alexmanuel27/PlanktoScope/Code/samples/photo_1764875718.jpg

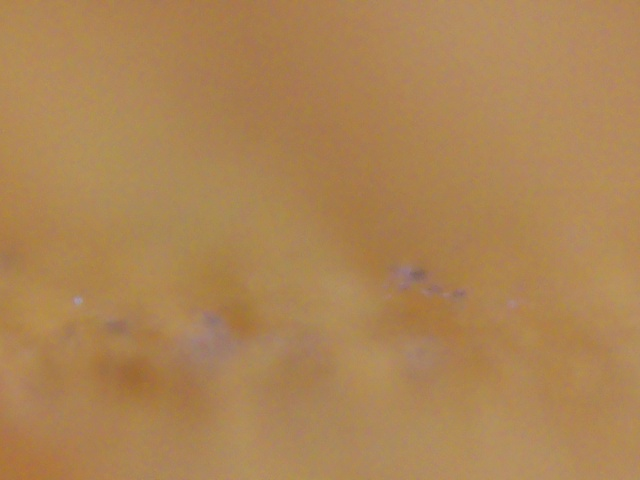
Code/samples/photo_1764875718.jpg
