alexmanuel27/PlanktoScope/Code/samples/photo_1764862161.jpg

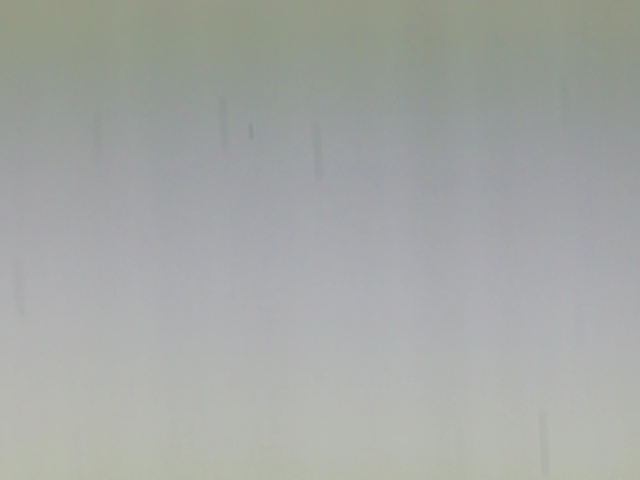
Code/samples/photo_1764862161.jpg
