alexmanuel27/PlanktoScope/Code/samples/photo_1764635275.jpg

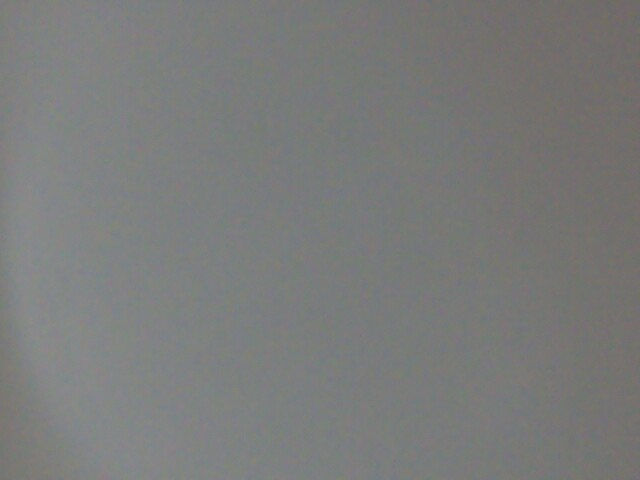
Code/samples/photo_1764635275.jpg
