alexmanuel27/PlanktoScope/datos/dataset_pm_mezcla_de_fuentes.jpg

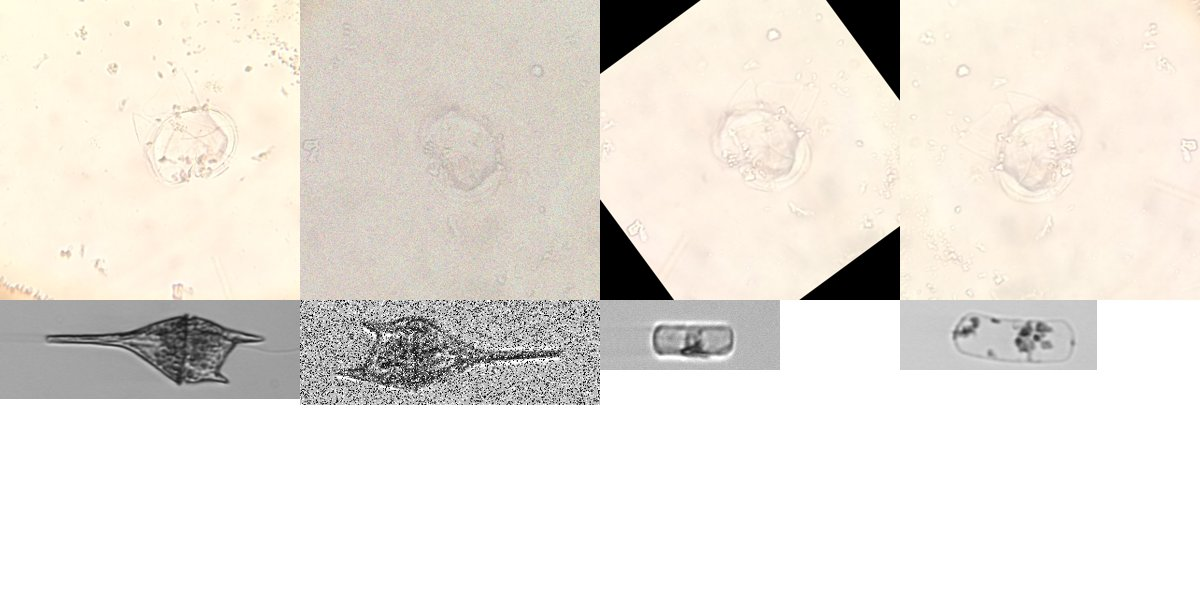
datos/dataset_pm_mezcla_de_fuentes.jpg
