alexmanuel27/PlanktoScope/modelos/plankton_mobilenet_v1/evaluacion_2026-09-27/confusion_limpio.png

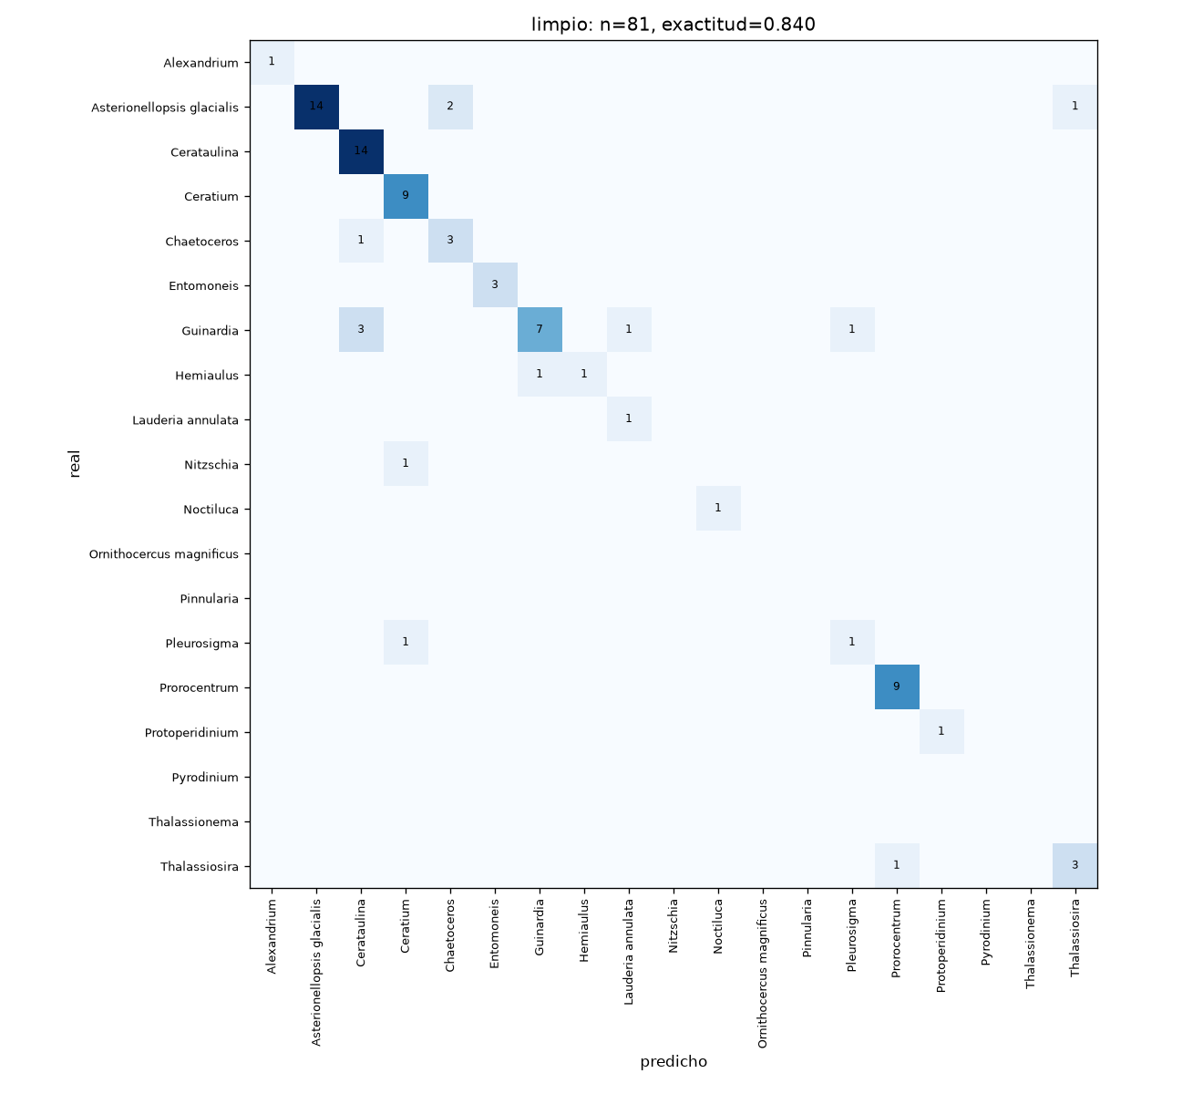
modelos/plankton_mobilenet_v1/evaluacion_2026-09-27/confusion_limpio.png
