alexmanuel27/PlanktoScope/(list of files, cad)

Other CAD files:
hardware/v2.1/case/PlanktoScope-Case (2)/0e850c2d-e7ce-4351-bac2-d7c185d7e647.f3d
hardware/v2.1/case/PlanktoScope-Case (2)/17e05918-feff-47e6-b392-b7af91a85d3e.f3d
hardware/v2.1/case/PlanktoScope-Case (2)/1a4a2817-b5f8-420c-9792-b29e91e8dcca.f3d
hardware/v2.1/case/PlanktoScope-Case (2)/1b2bbe5d-ce81-4713-bd27-330c6014a240.f3d
hardware/v2.1/case/PlanktoScope-Case (2)/1d477337-65d0-4aad-b7a3-bad6856ccf32.zip.f3d
hardware/v2.1/case/PlanktoScope-Case (2)/229278cc-a63a-4d60-ae79-3476006706c1.f3d
hardware/v2.1/case/PlanktoScope-Case (2)/39c13b6d-fd2f-492e-8767-e4eedb401456.f3d
hardware/v2.1/case/PlanktoScope-Case (2)/461afe21-81f9-453a-bc91-5f27020606c2.f3d
hardware/v2.1/case/PlanktoScope-Case (2)/48ae51cf-e409-4220-95ad-252bbba6209d.f3d
hardware/v2.1/case/PlanktoScope-Case (2)/49be9cc5-48d0-4a67-ab84-523c2f441036.f3d
hardware/v2.1/case/PlanktoScope-Case (2)/4abdbfde-54a1-46a7-9963-f6d3188fe159.f3d
hardware/v2.1/case/PlanktoScope-Case (2)/4e31985a-809a-47d1-84f4-eedf3f08d84d.f3d
hardware/v2.1/case/PlanktoScope-Case (2)/56b91e30-9c9f-4622-ba18-10aca97f1285.f3d
hardware/v2.1/case/PlanktoScope-Case (2)/5f8b7102-ca93-4f7e-ae2b-db1e94d02069.f3d
hardware/v2.1/case/PlanktoScope-Case (2)/6f789a65-b11d-4e2b-93b2-fccd86011b95.f3d
hardware/v2.1/case/PlanktoScope-Case (2)/71fed6c2-d2d2-4d90-9942-e3761ebb623a.f3d
hardware/v2.1/case/PlanktoScope-Case (2)/72acd83e-c714-40fa-b40f-245e58b6bd44.zip.f3d
hardware/v2.1/case/PlanktoScope-Case (2)/894af5d2-3cf9-48ae-962d-a460dfa0871c.f3d
hardware/v2.1/case/PlanktoScope-Case (2)/89d0933f-1a56-4870-be95-093551b69134.f3d
hardware/v2.1/case/PlanktoScope-Case (2)/a99cfc2e-9a65-4d40-9298-27492d5f2bd9.f3d
hardware/v2.1/case/PlanktoScope-Case (2)/b6c1d7c7-71d5-4f8c-a852-1080e0dc13f3.f3d
hardware/v2.1/case/PlanktoScope-Case (2)/b751b17d-3eb0-41a0-9004-12ad02d45ce2.f3d
hardware/v2.1/case/PlanktoScope-Case (2)/be1215d4-c3ec-41a3-ab22-ad0e6fc781e9.f3d
hardware/v2.1/case/PlanktoScope-Case (2)/ccd2134e-c44e-4f11-bd71-6ef3f181163e.f3d
hardware/v2.1/case/PlanktoScope-Case (2)/dddd11c0-e493-488c-b1b6-4b4cd47b6b13.f3d
hardware/v2.1/case/PlanktoScope-Case (2)/df5fb8b6-cb67-4064-a8af-0fe8c923339c.f3d
hardware/v2.1/case/PlanktoScope-Case (2)/fcee8e9f-2545-4671-880a-8952077a5481.f3d
hardware/v2.1/case/PlanktoScope-Case/0e850c2d-e7ce-4351-bac2-d7c185d7e647.f3d
hardware/v2.1/case/PlanktoScope-Case/17e05918-feff-47e6-b392-b7af91a85d3e.f3d
hardware/v2.1/case/PlanktoScope-Case/1a4a2817-b5f8-420c-9792-b29e91e8dcca.f3d
hardware/v2.1/case/PlanktoScope-Case/1b2bbe5d-ce81-4713-bd27-330c6014a240.f3d
hardware/v2.1/case/PlanktoScope-Case/1d477337-65d0-4aad-b7a3-bad6856ccf32.zip.f3d
hardware/v2.1/case/PlanktoScope-Case/229278cc-a63a-4d60-ae79-3476006706c1.f3d
hardware/v2.1/case/PlanktoScope-Case/39c13b6d-fd2f-492e-8767-e4eedb401456.f3d
hardware/v2.1/case/PlanktoScope-Case/461afe21-81f9-453a-bc91-5f27020606c2.f3d
hardware/v2.1/case/PlanktoScope-Case/48ae51cf-e409-4220-95ad-252bbba6209d.f3d
hardware/v2.1/case/PlanktoScope-Case/49be9cc5-48d0-4a67-ab84-523c2f441036.f3d
hardware/v2.1/case/PlanktoScope-Case/4abdbfde-54a1-46a7-9963-f6d3188fe159.f3d
hardware/v2.1/case/PlanktoScope-Case/4e31985a-809a-47d1-84f4-eedf3f08d84d.f3d
hardware/v2.1/case/PlanktoScope-Case/56b91e30-9c9f-4622-ba18-10aca97f1285.f3d
hardware/v2.1/case/PlanktoScope-Case/5f8b7102-ca93-4f7e-ae2b-db1e94d02069.f3d
hardware/v2.1/case/PlanktoScope-Case/6f789a65-b11d-4e2b-93b2-fccd86011b95.f3d
hardware/v2.1/case/PlanktoScope-Case/71fed6c2-d2d2-4d90-9942-e3761ebb623a.f3d
hardware/v2.1/case/PlanktoScope-Case/72acd83e-c714-40fa-b40f-245e58b6bd44.zip.f3d
hardware/v2.1/case/PlanktoScope-Case/894af5d2-3cf9-48ae-962d-a460dfa0871c.f3d
hardware/v2.1/case/PlanktoScope-Case/89d0933f-1a56-4870-be95-093551b69134.f3d
hardware/v2.1/case/PlanktoScope-Case/a99cfc2e-9a65-4d40-9298-27492d5f2bd9.f3d
hardware/v2.1/case/PlanktoScope-Case/b6c1d7c7-71d5-4f8c-a852-1080e0dc13f3.f3d
hardware/v2.1/case/PlanktoScope-Case/b751b17d-3eb0-41a0-9004-12ad02d45ce2.f3d
hardware/v2.1/case/PlanktoScope-Case/be1215d4-c3ec-41a3-ab22-ad0e6fc781e9.f3d
hardware/v2.1/case/PlanktoScope-Case/ccd2134e-c44e-4f11-bd71-6ef3f181163e.f3d
hardware/v2.1/case/PlanktoScope-Case/dddd11c0-e493-488c-b1b6-4b4cd47b6b13.f3d
hardware/v2.1/case/PlanktoScope-Case/df5fb8b6-cb67-4064-a8af-0fe8c923339c.f3d
hardware/v2.1/case/PlanktoScope-Case/fcee8e9f-2545-4671-880a-8952077a5481.f3d
