alexmanuel27/PlanktoScope/modelos/plankton_mobilenet_v1/evaluacion_2026-09-27/predicciones_test_original.csv

imagen | real | predicho | confianza
test/Alexandrium/1_0.png | Alexandrium | Alexandrium | 1.0000
test/Alexandrium/1_1.png | Alexandrium | Alexandrium | 0.9995
test/Asterionellopsis glacialis/2_0.png | Asterionellopsis glacialis | Asterionellopsis glacialis | 0.9997
test/Asterionellopsis glacialis/2_1.png | Asterionellopsis glacialis | Asterionellopsis glacialis | 0.9999
test/Asterionellopsis glacialis/2_10.png | Asterionellopsis glacialis | Asterionellopsis glacialis | 0.9999
test/Asterionellopsis glacialis/2_11.png | Asterionellopsis glacialis | Asterionellopsis glacialis | 1.0000
test/Asterionellopsis glacialis/2_12.png | Asterionellopsis glacialis | Asterionellopsis glacialis | 0.9999
test/Asterionellopsis glacialis/2_13.png | Asterionellopsis glacialis | Asterionellopsis glacialis | 0.9981
test/Asterionellopsis glacialis/2_14.png | Asterionellopsis glacialis | Asterionellopsis glacialis | 1.0000
test/Asterionellopsis glacialis/2_15.png | Asterionellopsis glacialis | Asterionellopsis glacialis | 0.9953
test/Asterionellopsis glacialis/2_16.png | Asterionellopsis glacialis | Asterionellopsis glacialis | 0.9999
test/Asterionellopsis glacialis/2_17.png | Asterionellopsis glacialis | Asterionellopsis glacialis | 0.9981
test/Asterionellopsis glacialis/2_18.png | Asterionellopsis glacialis | Asterionellopsis glacialis | 0.9999
test/Asterionellopsis glacialis/2_2.png | Asterionellopsis glacialis | Asterionellopsis glacialis | 0.9973
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
test/Thalassiosira/19_3.png | Thalassiosira | Thalassiosira | 0.9998
test/Thalassiosira/19_4.png | Thalassiosira | Thalassiosira | 0.9982
test/Thalassiosira/19_5.png | Thalassiosira | Thalassiosira | 0.9999
test/Thalassiosira/19_6.png | Thalassiosira | Thalassiosira | 1.0000
