alexmanuel27/PlanktoScope/hardware/v2.5/hat/salida.pdf

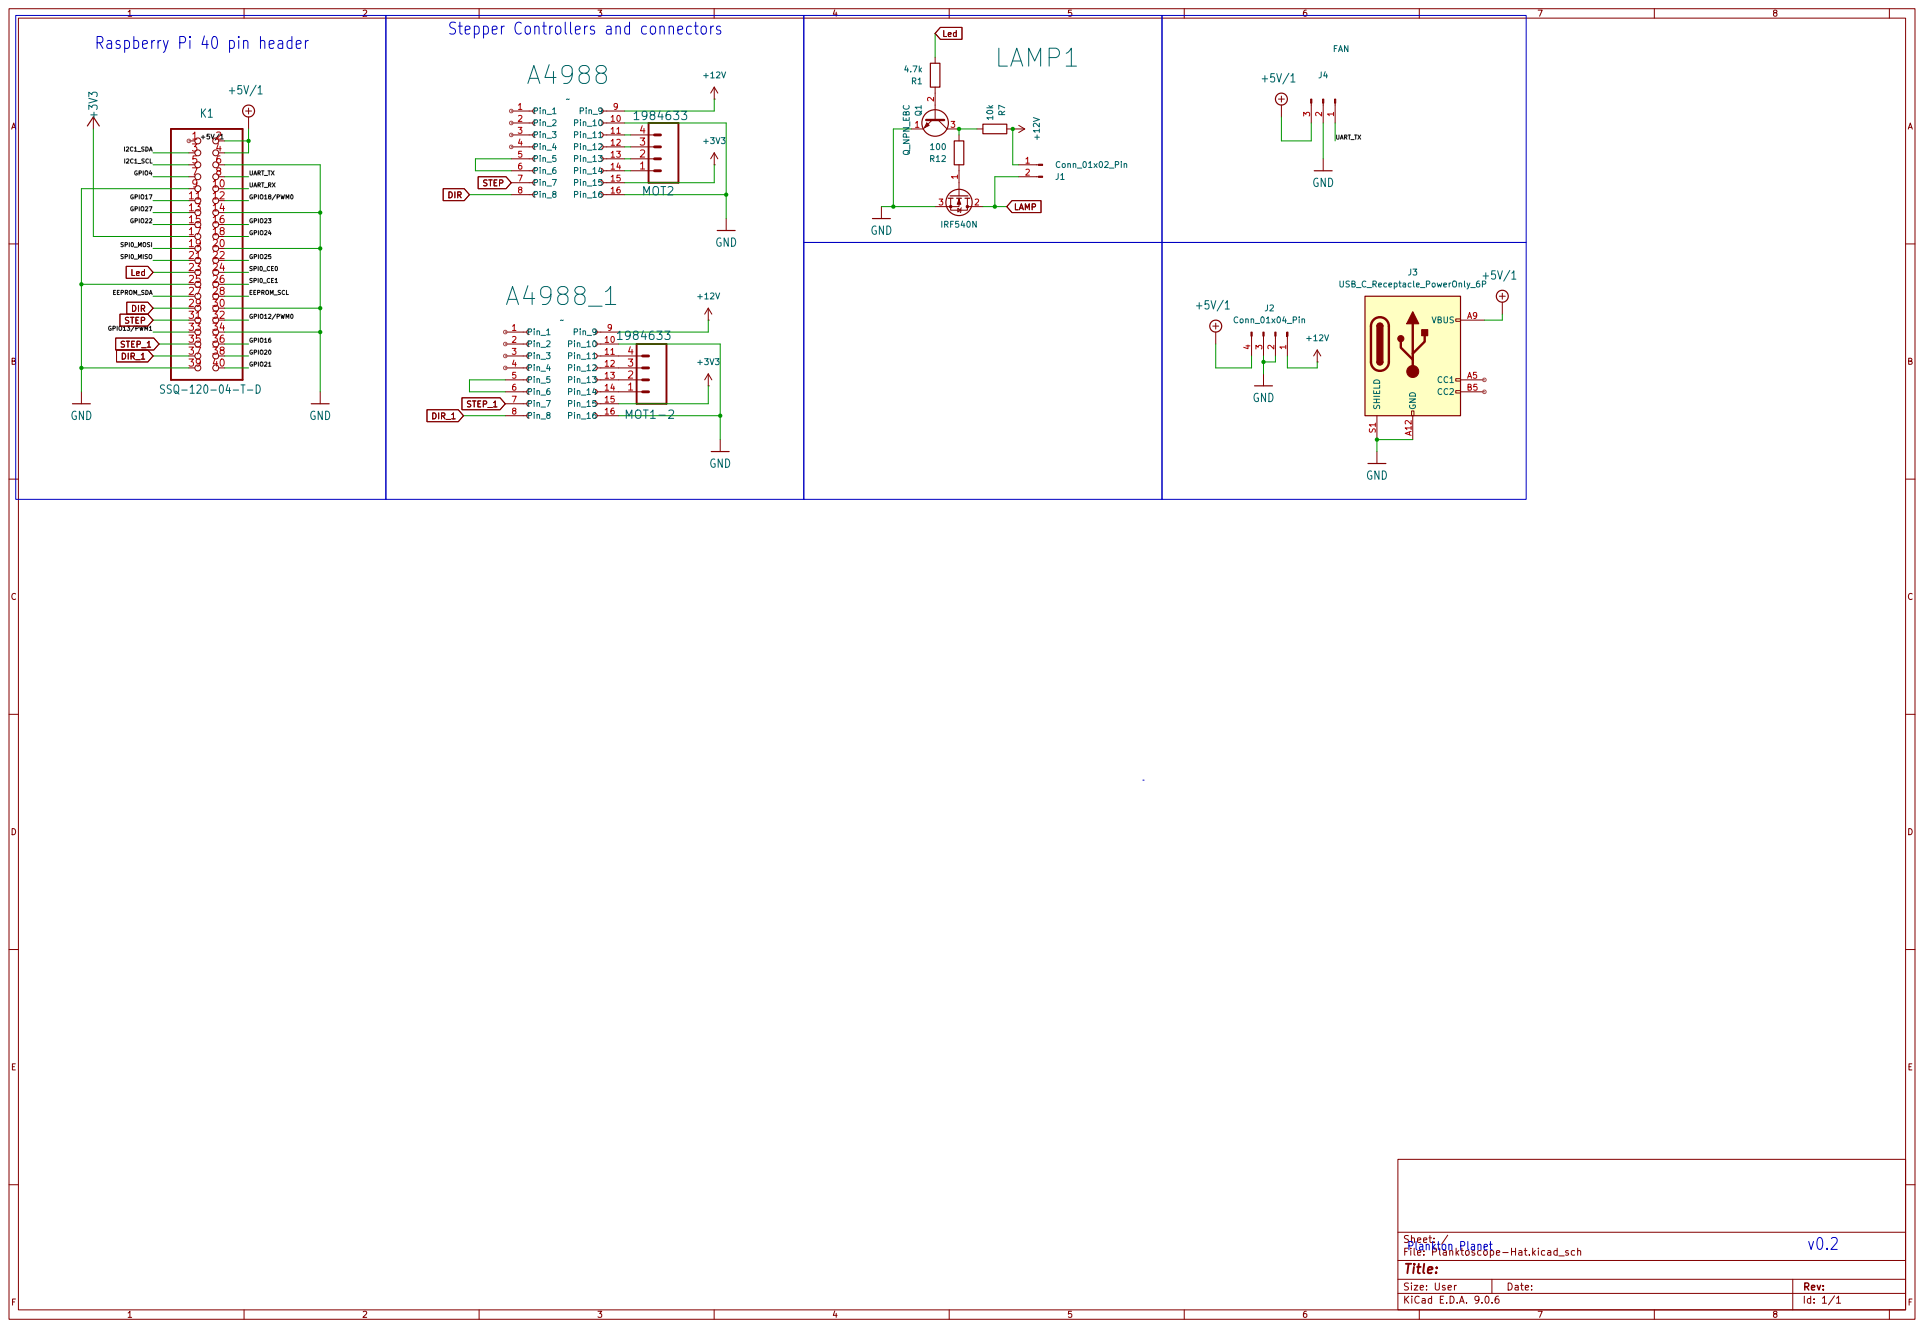
[picture p6: page 1]
