alexmanuel27/PlanktoScope/hardware/v2.5/hat/Planktoscope-Hat.kicad_pcb

## KiCad design hardware/v2.5/hat/Planktoscope-Hat.kicad_pcb (2025-12-02)

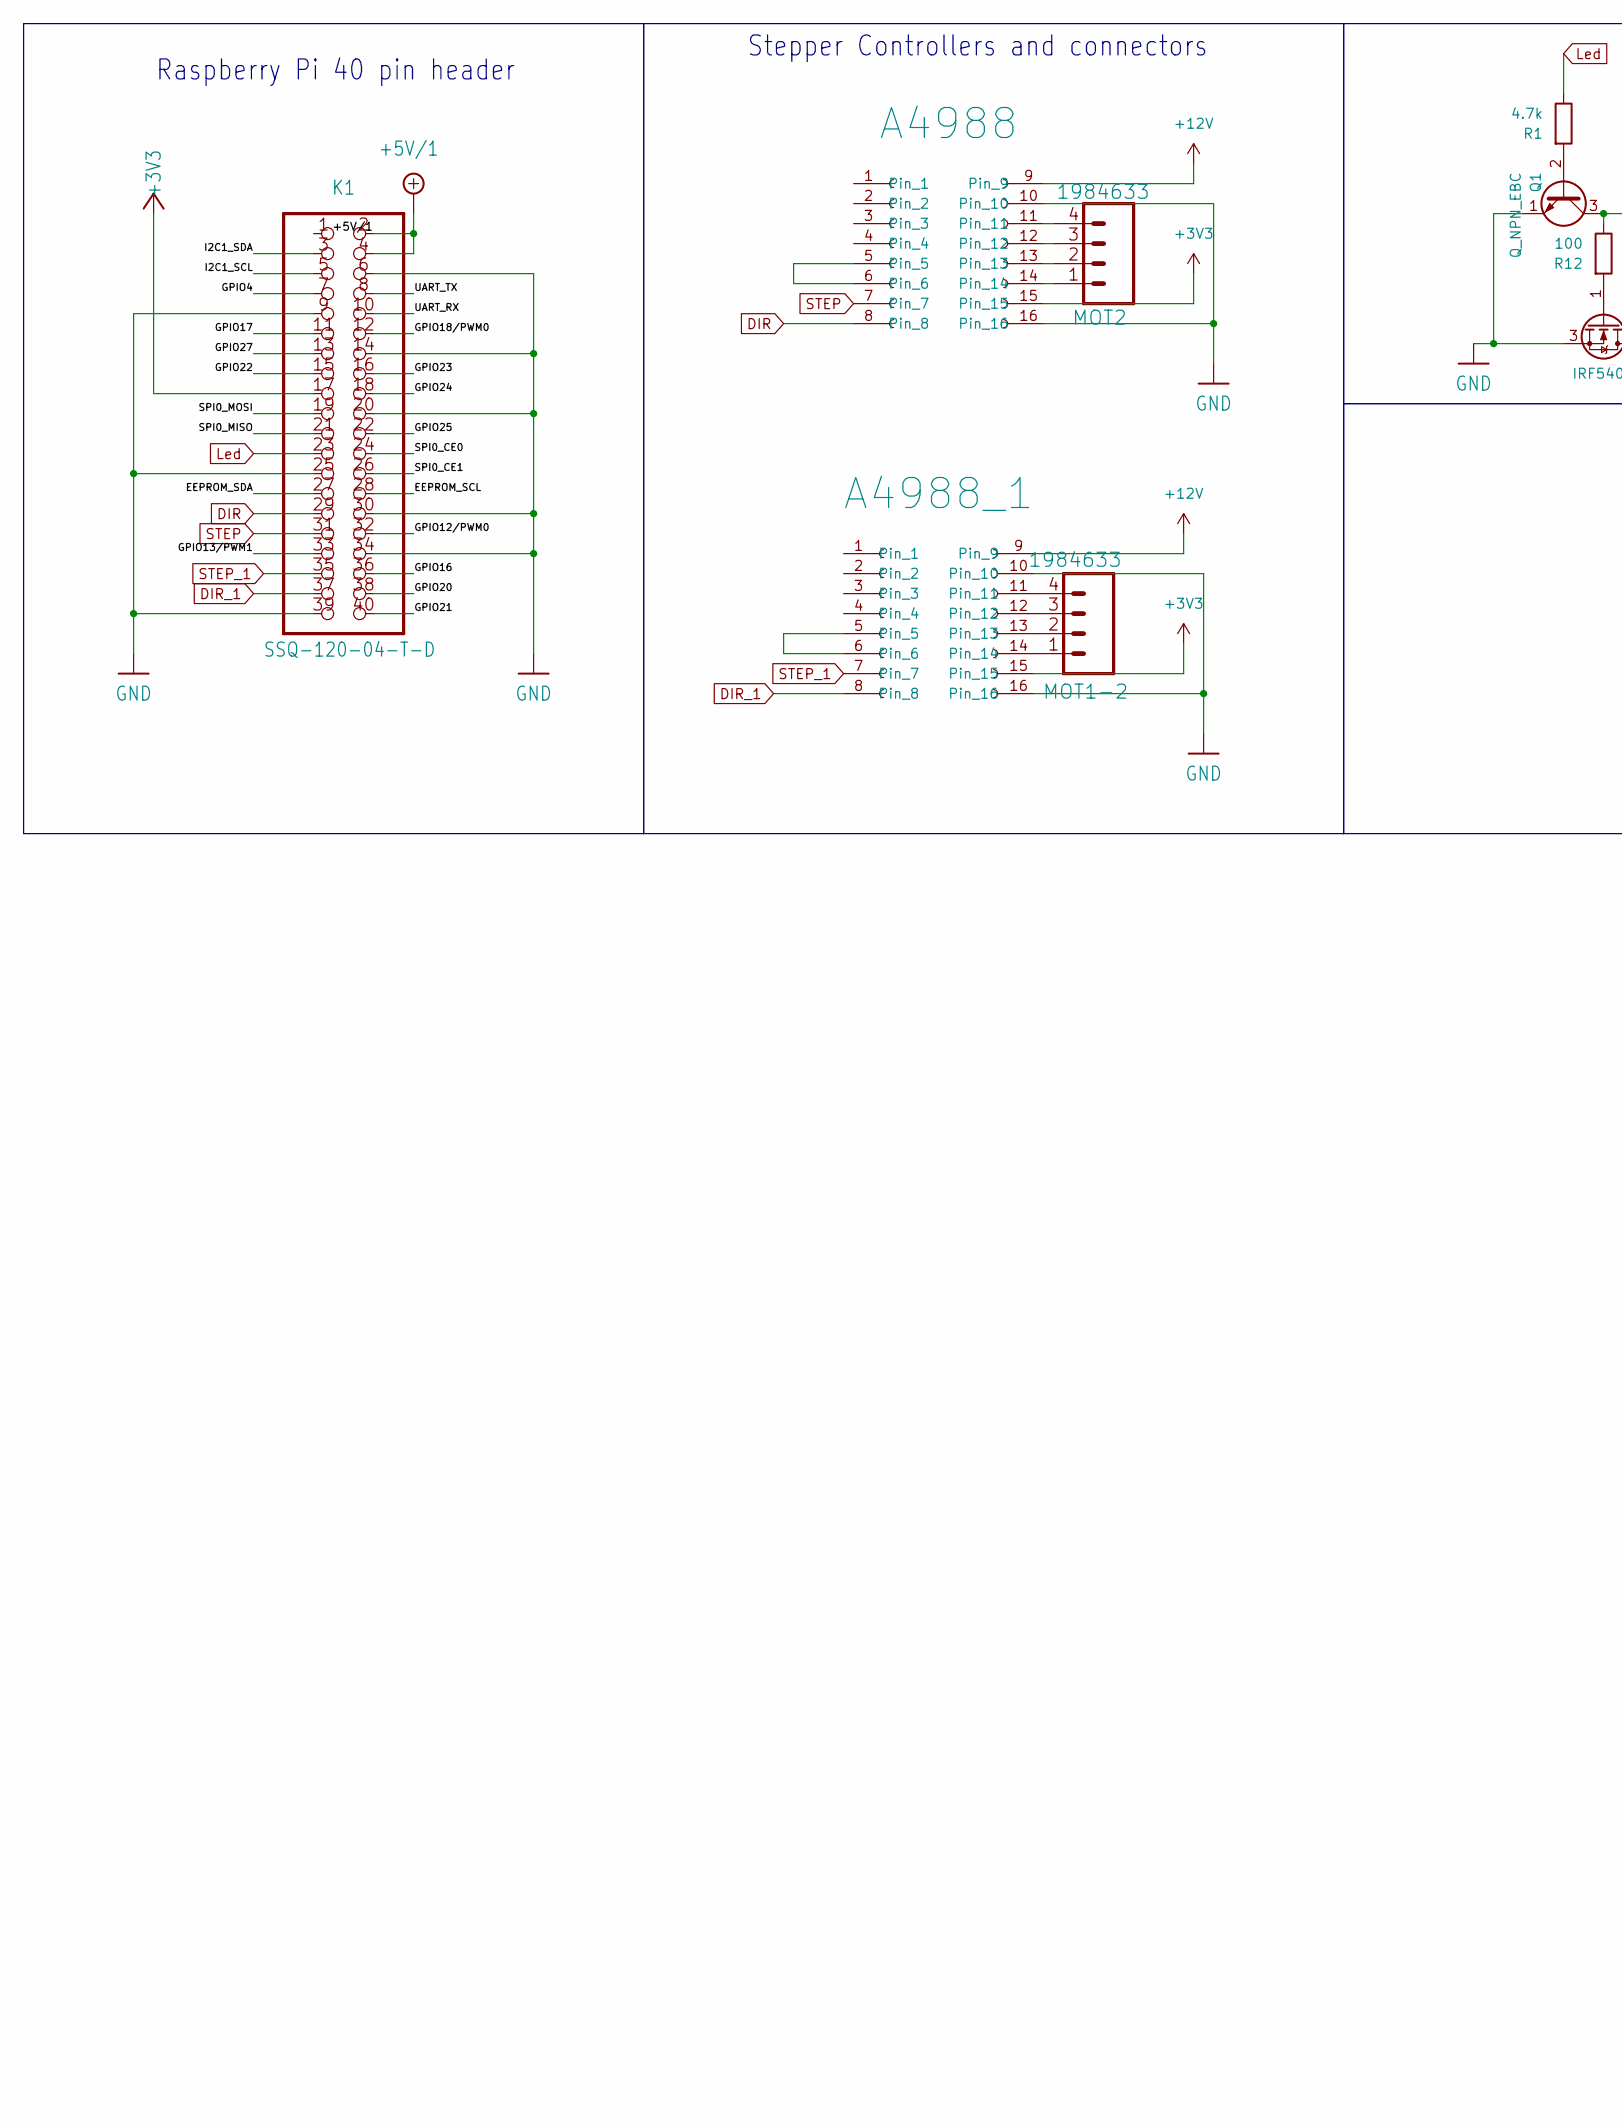
[picture p7: schematic Planktoscope-Hat.kicad_sch, part in row 1, column 1]

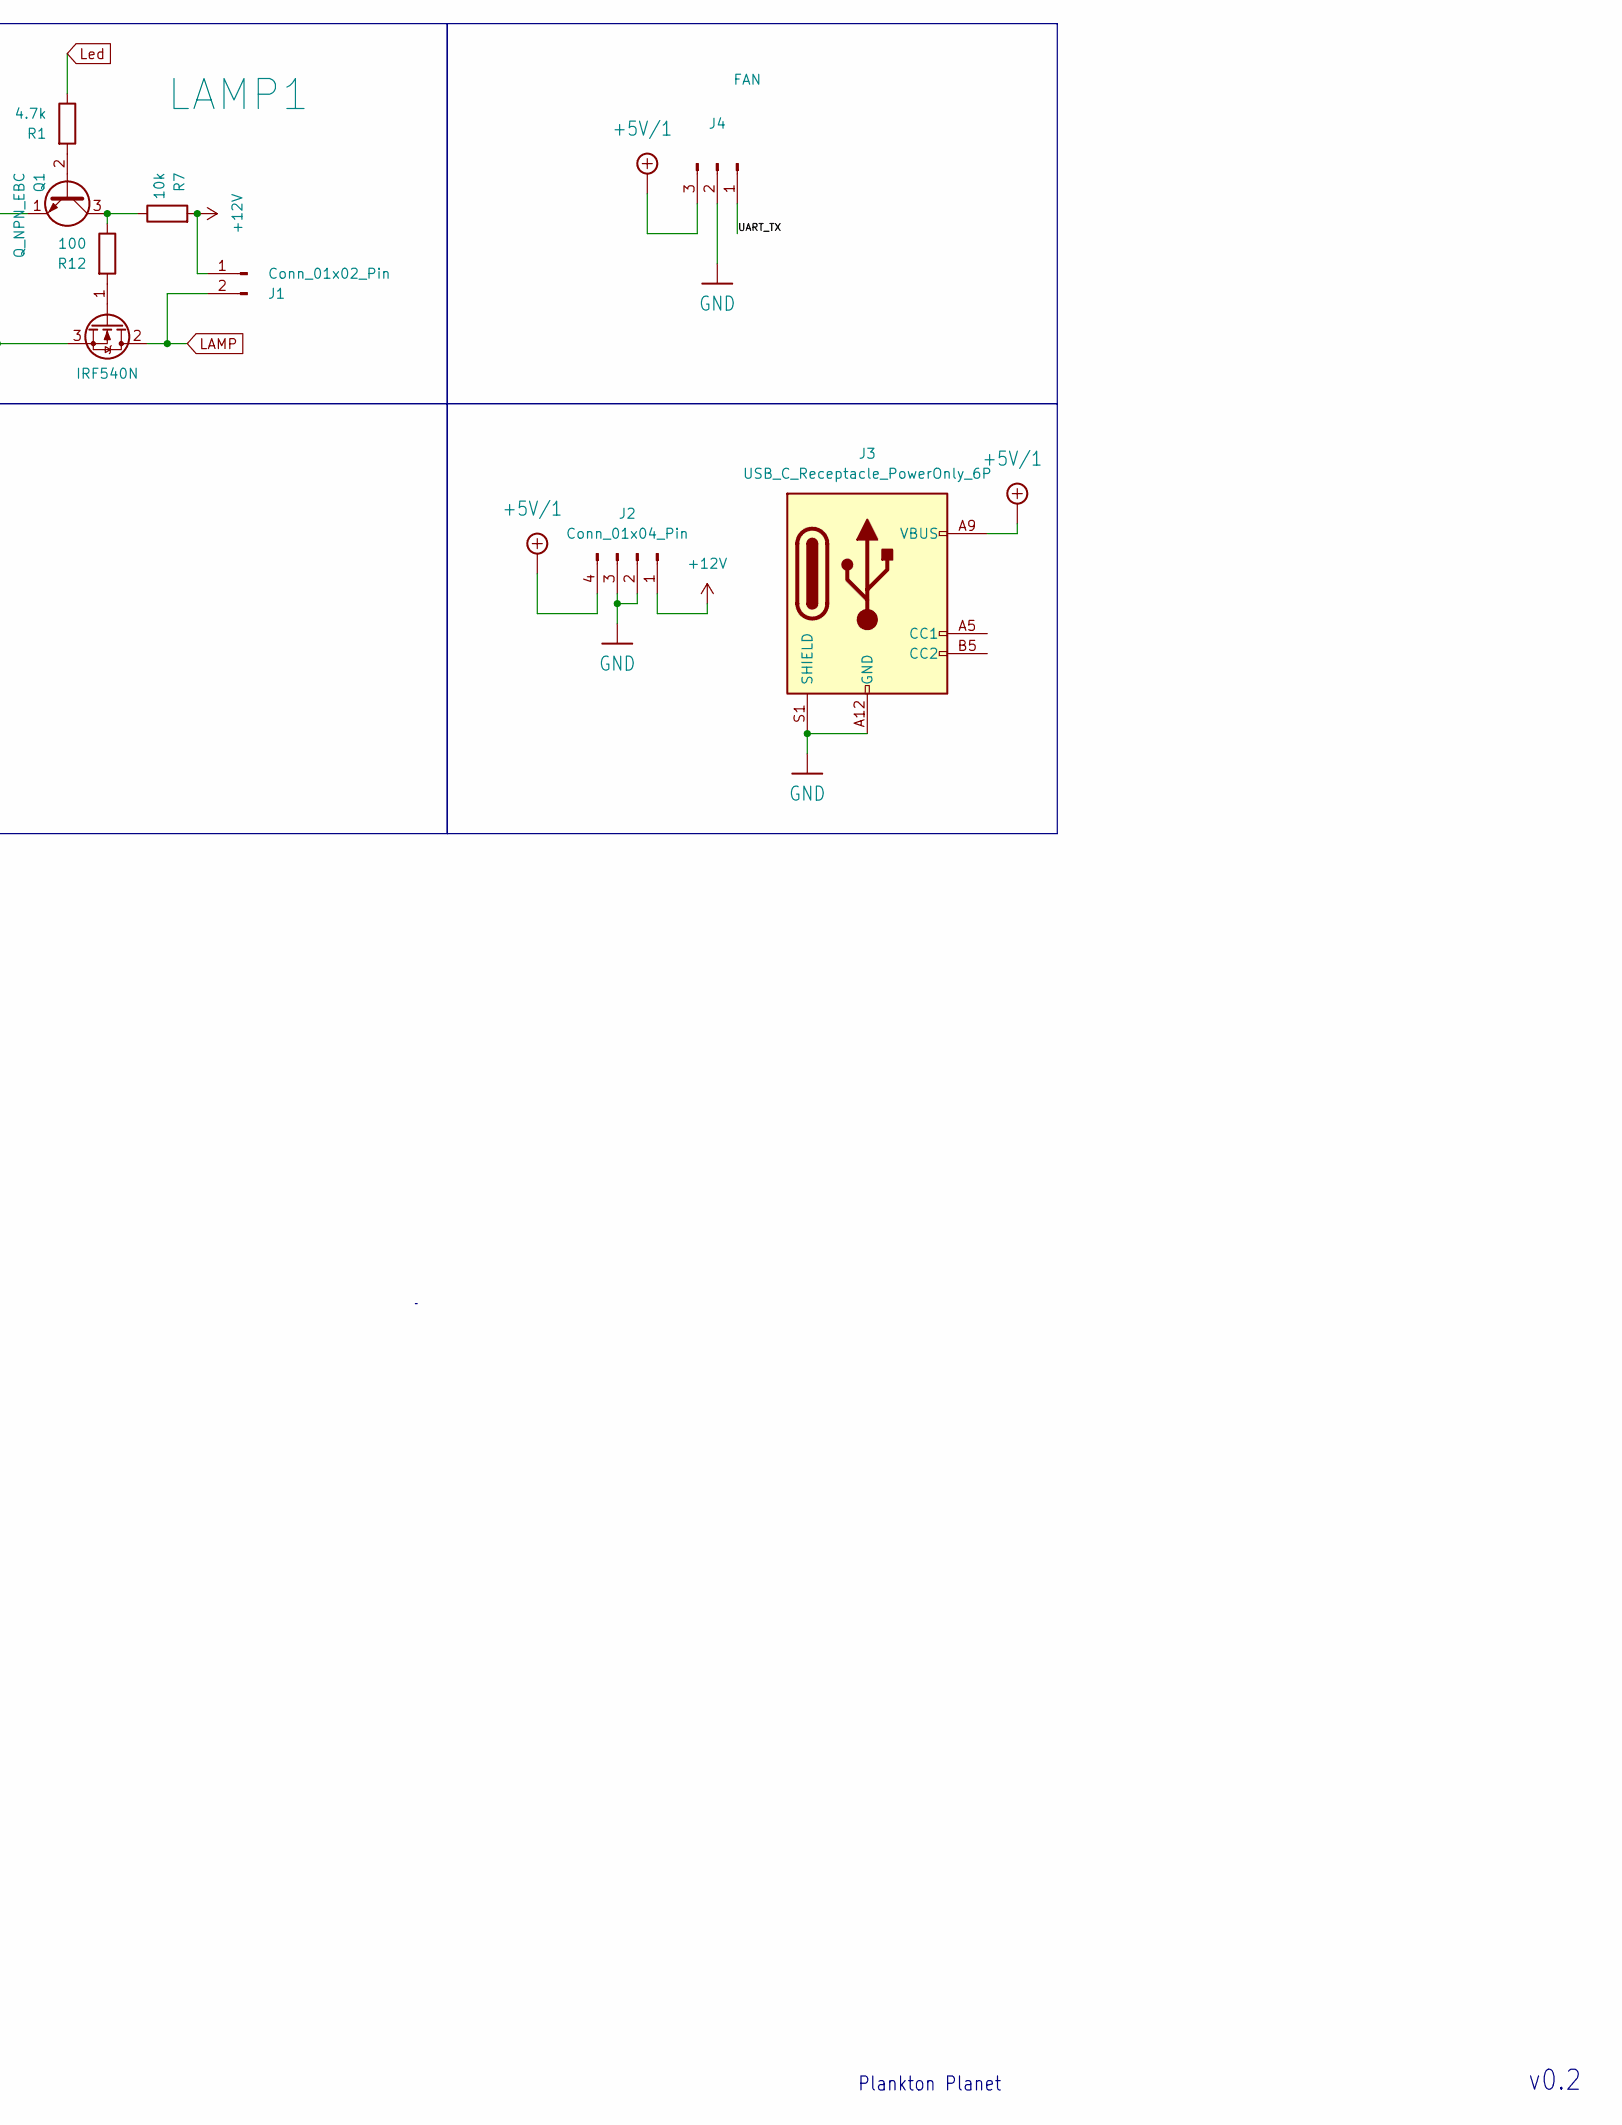
[picture p8: schematic Planktoscope-Hat.kicad_sch, part in row 1, column 2]

Parts:
A4988, A4988_1: POLOLU_SMD
J1: Conn_01x02_Pin; PinHeader_1x02_P2.54mm_Horizontal
J2: Conn_01x04_Pin; dc-dc up
J3: USB_C_Receptacle_PowerOnly_6P; USB_C_Receptacle_GCT_USB4135-GF-A_6P_TopMnt_Horizontal
J4: FAN; PinHeader_1x03_P2.54mm_Horizontal
K1: SSQ-120-04-T-D; Raspberry_Pi_Zero_Socketed_THT_FaceDown_MountingHoles
LAMP1: IRF540N; TO-263-2
MOT1-2, MOT2: 1984633; PinHeader_1x04_P2.54mm_Horizontal
Q1: Q_NPN_EBC; TO-92L_Inline_Wide
R1: 4.7k; D_1206_3216Metric
R7: 10k; D_1206_3216Metric
R12: 100; D_1206_3216Metric

Connections:
+3V3: A4988.15, A4988_1.15, K1.17
+5V/1: J2.4, J3.A9 (VBUS), J3.B9 (VBUS), J4.3, K1.2, K1.4
+12V: A4988.9, A4988_1.9, J1.1, J2.1, R7.2
/EEPROM_SCL: K1.28
/EEPROM_SDA: K1.27
/GPIO4: K1.7
/GPIO12/PWM0: K1.32
/GPIO13/PWM1: K1.33
/GPIO16: K1.36
/GPIO17: K1.11
/GPIO18/PWM0: K1.12
/GPIO20: K1.38
/GPIO21: K1.40
/GPIO22: K1.15
/GPIO23: K1.16
/GPIO24: K1.18
/GPIO25: K1.22
/GPIO27: K1.13
/I2C1_SCL: K1.5
/I2C1_SDA: K1.3
/SPI0_CE0: K1.24
/SPI0_CE1: K1.26
/SPI0_MISO: K1.21
/SPI0_MOSI: K1.19
/UART_RX: K1.10
/UART_TX: J4.1, K1.8
DIR: A4988.8, K1.29
DIR_1: A4988_1.8, K1.37
GND: A4988.10, A4988.16, A4988_1.10, A4988_1.16, J2.2, J2.3, J3.A12 (GND), J3.B12 (GND), J3.S1 (SHIELD), J4.2, K1.6, K1.9, K1.14, K1.20, K1.25, K1.30, K1.34, K1.39, LAMP1.3 (S), Q1.1 (E)
LAMP: J1.2, LAMP1.2 (D)
Led: K1.23, R1.1
unnamed: A4988.5, A4988.6
unnamed: A4988.11, MOT2.4
unnamed: A4988.12, MOT2.3
unnamed: A4988.13, MOT2.2
unnamed: A4988.14, MOT2.1
unnamed: A4988_1.5, A4988_1.6
unnamed: A4988_1.11, MOT1-2.4
unnamed: A4988_1.12, MOT1-2.3
unnamed: A4988_1.13, MOT1-2.2
unnamed: A4988_1.14, MOT1-2.1
unnamed: LAMP1.1 (G), R12.2
unnamed: Q1.2 (B), R1.2
unnamed: Q1.3 (C), R7.1, R12.1
STEP: A4988.7, K1.31
STEP_1: A4988_1.7, K1.35

Notes on the sheet:
Stepper Controllers and connectors
v0.2
Plankton Planet
Raspberry Pi 40 pin header

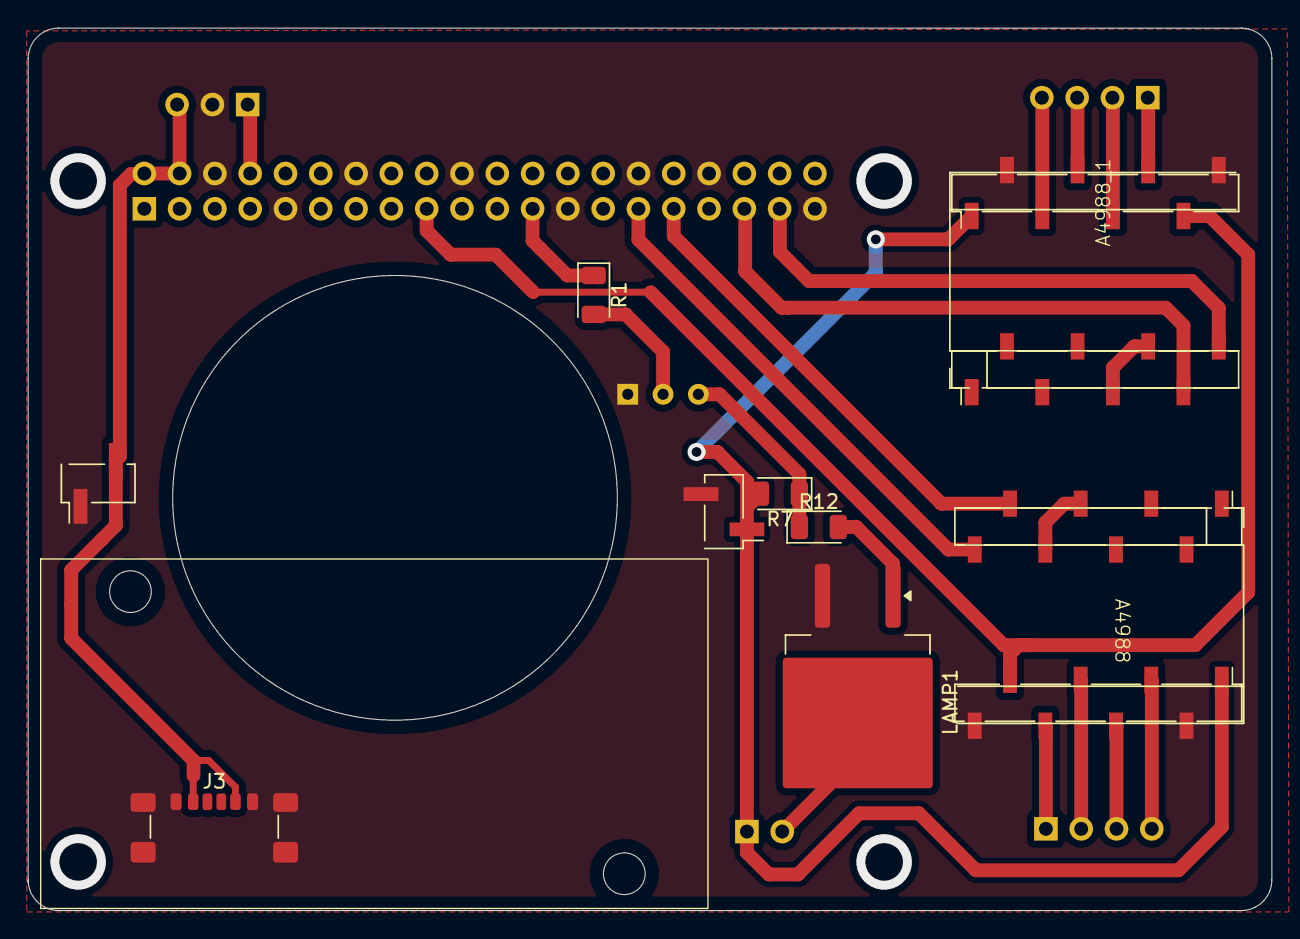
[picture p9: board Planktoscope-Hat.kicad_pcb from above]

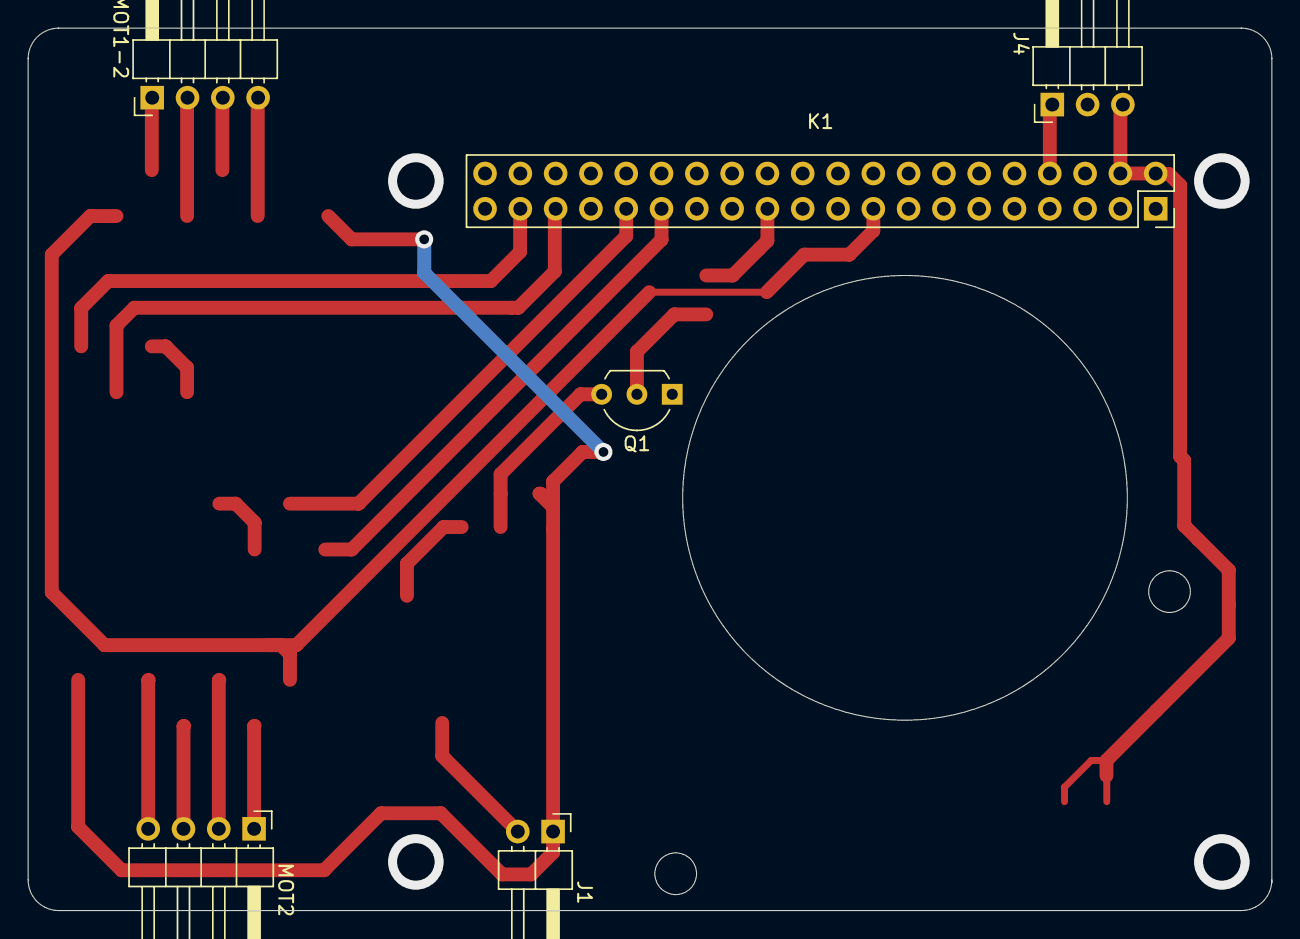
[picture p10: board Planktoscope-Hat.kicad_pcb from below]

Board: 2 copper layers, 89.5 x 63.5 mm, 14 parts (6 on the bottom side), 24 nets.
