alexmanuel27/PlanktoScope/Code/app.py

# app.py
from flask import Flask, render_template, jsonify, send_file, send_from_directory, Response, request
import time
import os
import subprocess
import threading
import json
from datetime import datetime
from queue import Queue
from threading import Lock
import cv2
import numpy as np
import RPi.GPIO as GPIO
import math
import tempfile
import zipfile
import atexit

try:
    from picamera2 import Picamera2
    from picamera2.encoders import H264Encoder
    from picamera2.outputs import FileOutput
    CAMERA_AVAILABLE = True
except ImportError:
    CAMERA_AVAILABLE = False

from ml.detector import detectar  # solo necesita OpenCV: la detección funciona aunque falle el clasificador

# ========== Clasificador de plancton ==========
try:
    from ml.classifier import classify_image
    CLASSIFIER_AVAILABLE = True
    print("✅ Plankton classifier loaded")
except Exception as e:
    CLASSIFIER_AVAILABLE = False
    print(f"❌ Classifier error: {e}")

app = Flask(__name__)
SAMPLES_DIR = os.path.join(os.path.dirname(__file__), "samples")
CONFIG_FILE = os.path.join(os.path.dirname(__file__), "config.json")
FOCUS_STATE_JFILE = os.path.join(os.path.dirname(__file__), "focus_state.json")
COUNTER_FILE = os.path.join(SAMPLES_DIR, "counter.json")
os.makedirs(SAMPLES_DIR, exist_ok=True)

# ========== Variables globales ==========
last_annotated_frame = None
last_annotation_time = 0
last_classification = {"label": "unknown", "confidence": 0.0}
ignore_focus_limits = False

def should_clear_annotations():
    current_time = time.time()
    return current_time - last_annotation_time > 10.0

def annotate_frame(frame, classifications):
    for obj in classifications:
        x, y, w, h = obj["x"], obj["y"], obj["w"], obj["h"]
        label = obj["label"]
        confidence = obj["confidence"]
        color = (0, 0, 0)  # ✅ Siempre negro
        cv2.rectangle(frame, (x, y), (x+w, y+h), color, 2)
        label_text = f"{label} ({int(confidence)}%)" if confidence > 0 else "unknown"
        font = cv2.FONT_HERSHEY_SIMPLEX
        font_scale = 0.5
        thickness = 1
        text_x = x + 5
        text_y = y - 10 if y - 10 > 10 else y + h + 20
        cv2.putText(frame, label_text, (text_x, text_y), font, font_scale, color, thickness)
    return frame

# ========== Cargar configuración ==========
def load_config():
    default_config = {
        "stepper1": {"dir_pin": 26, "step_pin": 19, "enable_pin": 13, "steps_take_sample": 2000, "delay": 0.002,
                     "ramp_steps": 200, "led_delay_after_pump": 1.0},
        "stepper2": {"dir_pin": 5, "step_pin": 6, "enable_pin": 9, "steps_focus": 100, "delay": 0.002, "ramp_steps": 0,
                     "focus_min": 40, "focus_max": 60}
    }
    if os.path.exists(CONFIG_FILE):
        with open(CONFIG_FILE, "r") as f:
            config = json.load(f)
            for key in ["stepper1", "stepper2"]:
                config[key] = {**default_config[key], **config.get(key, {})}  # rellena solo lo que falte
    else:
        config = default_config
        save_config(config)
    return config

def guardar_json(path, data):
    """Escritura atómica: o queda el fichero viejo entero o el nuevo entero, nunca uno a medias."""
    tmp = path + ".tmp"
    with open(tmp, "w") as f:
        json.dump(data, f, indent=4)
        f.flush()
        os.fsync(f.fileno())
    os.replace(tmp, path)

def save_config(config):
    guardar_json(CONFIG_FILE, config)

# ========== Cargar/guardar estado del foco ==========
def load_focus_state():
    try:
        with open(FOCUS_STATE_JFILE, "r") as f:
            return json.load(f)
    except Exception as e:
        print(f"⚠️ focus_state.json no se pudo leer ({e}); el foco arranca en 100 y NO es su posición real")
        return {"step": 100}

def save_focus_state(state):
    guardar_json(FOCUS_STATE_JFILE, state)

# ========== Cargar/guardar contador ==========
def load_counter():
    default = {"photo": 0, "video": 0}
    if os.path.exists(COUNTER_FILE):
        try:
            with open(COUNTER_FILE, "r") as f:
                return json.load(f)
        except:
            pass
    return default

def save_counter(counter):
    guardar_json(COUNTER_FILE, counter)

# ========== Rutas y funciones ==========
@app.route("/")
def index():
    files = []
    for f in os.listdir(SAMPLES_DIR):
        if f.lower().endswith(('.jpg', '.jpeg', '.mp4', '.txt')):
            path = os.path.join(SAMPLES_DIR, f)
            files.append({
                "id": f,
                "time": datetime.fromtimestamp(os.path.getmtime(path)).strftime("%Y-%m-%d %H:%M:%S"),
                "type": "photo" if f.lower().endswith(('.jpg', '.jpeg')) else "video" if f.lower().endswith('.mp4') else "data"
            })
    files.sort(key=lambda x: x["time"], reverse=True)
    return render_template("index.html", initial_samples=files)

@app.route("/api/config", methods=["GET", "POST"])
def handle_config():
    global config
    if request.method == "POST":
        try:
            new_config = request.json
            for key in ["stepper1", "stepper2"]:
                new_config[key] = {**config.get(key, {}), **new_config[key]}  # conservar lo que la web no envía (delay, rampa)
                new_config[key]["dir_pin"] = int(new_config[key]["dir_pin"])
                new_config[key]["step_pin"] = int(new_config[key]["step_pin"])
                new_config[key]["enable_pin"] = int(new_config[key]["enable_pin"])
                new_config[key]["steps_take_sample"] = int(new_config[key].get("steps_take_sample", 2000))
                new_config[key]["steps_focus"] = int(new_config[key].get("steps_focus", 100))
                new_config[key]["delay"] = float(new_config[key].get("delay", 0.0005))
                if key == "stepper2":
                    new_config[key]["focus_min"] = int(new_config[key].get("focus_min", 40))
                    new_config[key]["focus_max"] = int(new_config[key].get("focus_max", 60))
            save_config(new_config)
            config = new_config
            
            _motor_lock.acquire()  # esperar a que termine cualquier movimiento
            try:
                # sin GPIO.cleanup(): soltar los pines dejaría EN a GND y activaría los motores
            
                GPIO.setup(config["stepper1"]["dir_pin"], GPIO.OUT)
                GPIO.setup(config["stepper1"]["step_pin"], GPIO.OUT)
                GPIO.setup(config["stepper1"]["enable_pin"], GPIO.OUT)
                GPIO.output(config["stepper1"]["enable_pin"], GPIO.HIGH)
            
                GPIO.setup(config["stepper2"]["dir_pin"], GPIO.OUT)
                GPIO.setup(config["stepper2"]["step_pin"], GPIO.OUT)
                GPIO.setup(config["stepper2"]["enable_pin"], GPIO.OUT)
                GPIO.output(config["stepper2"]["enable_pin"], GPIO.HIGH)
            
                GPIO.setup(LED_PIN, GPIO.OUT)
                GPIO.output(LED_PIN, GPIO.HIGH if not led_state else GPIO.LOW)
            finally:
                _motor_lock.release()
            
            log_to_console("Configuration updated")
            return jsonify(status="ok")
        except Exception as e:
            return jsonify(error=str(e)), 400
    return jsonify(config)

@app.route("/api/focus/current")
def get_focus_current():
    return jsonify(step=focus_step)

@app.route("/api/focus/ignore", methods=["POST"])
def toggle_ignore_limits():
    global ignore_focus_limits
    data = request.get_json(silent=True) or {}
    ignore_focus_limits = bool(data["ignore"]) if "ignore" in data else not ignore_focus_limits
    log_to_console(f"Focus limits ignored: {ignore_focus_limits}")
    return jsonify(status="ok", ignore=ignore_focus_limits)

def led_hw(on, suave=False):
    """Enciende/apaga el LED (lógica invertida: LOW = encendido). suave=True sube en ~0,5 s con PWM
    para que el pico de corriente del encendido no llegue de golpe."""
    if on and suave:
        try:
            p = GPIO.PWM(LED_PIN, 200)
            p.start(100)                        # 100 % en alto = apagado
            for d in range(100, -1, -5):
                p.ChangeDutyCycle(d)
                time.sleep(0.025)
            p.stop()
            del p
        except Exception as e:
            log_to_console(f"LED soft-start error: {e}")
    GPIO.output(LED_PIN, GPIO.LOW if on else GPIO.HIGH)

@app.route("/api/time", methods=["POST"])
def sync_time():
    """La Raspberry no tiene internet ni reloj con pila: si su hora se desvía más de 1 min de la del
    navegador que se conecta, la corrige (el servicio corre como alex, que tiene sudo sin contraseña)."""
    try:
        t = float((request.get_json(silent=True) or {})["epoch"])
    except Exception:
        return jsonify(error="epoch requerido"), 400
    if t < 1.7e9:                                   # hora del navegador absurda (antes de 2023): no tocar
        return jsonify(error="hora del navegador no válida"), 400
    diff = t - time.time()
    if abs(diff) > 60:
        r = subprocess.run(["sudo", "-n", "date", "-s", f"@{int(t)}"], capture_output=True, text=True)
        if r.returncode != 0:
            log_to_console(f"No se pudo poner la hora: {r.stderr.strip()}")
            return jsonify(error="sudo date falló"), 500
        log_to_console(f"Hora corregida desde el navegador ({diff:+.0f} s)")
    return jsonify(status="ok", diff=round(diff))

@app.route("/api/state")
def get_state():
    """Lo que cada navegador debe mostrar al abrir la página, venga de donde venga."""
    return jsonify(focus_step=focus_step, led=led_state, ignore_focus_limits=ignore_focus_limits)

@app.route("/api/led/toggle")
def toggle_led():
    global led_state
    led_state = not led_state
    led_hw(led_state, suave=True)
    status = "ON" if led_state else "OFF"
    log_to_console(f"LED turned {status}")
    return jsonify(state=led_state, status=status)

_motor_lock = Lock()  # un motor cada vez: no se cruzan pulsos ni se suman picos de corriente

def rampa(steps, t_min, t_start, ramp):
    """Semiperiodo de cada paso: arranca a t_start, crucero a t_min y frena simétrico."""
    ramp = min(ramp, steps // 2)
    for i in range(steps):
        k = min(i, steps - 1 - i, ramp)
        yield t_min if ramp == 0 else t_start - (t_start - t_min) * k / ramp

def move_stepper(stepper_key, direction, steps):
    c = config[stepper_key]
    with _motor_lock:
        GPIO.output(c["dir_pin"], GPIO.HIGH if direction == "forward" else GPIO.LOW)
        GPIO.output(c["enable_pin"], GPIO.LOW)
        time.sleep(0.01)
        try:
            for d in rampa(steps, c["delay"], c.get("delay_start", 0.002), c.get("ramp_steps", 200)):
                GPIO.output(c["step_pin"], GPIO.HIGH)
                time.sleep(d)
                GPIO.output(c["step_pin"], GPIO.LOW)
                time.sleep(d)
        finally:
            GPIO.output(c["enable_pin"], GPIO.HIGH)  # desactivar siempre, aunque falle a mitad

@app.route("/api/focus/<direction>")
def focus(direction):
    global focus_step, ignore_focus_limits
    steps = config["stepper2"]["steps_focus"]
    
    if direction == "in":
        if not ignore_focus_limits and focus_step + steps > config["stepper2"]["focus_max"]:
            return jsonify(error=f"Focus limit exceeded (max: {config['stepper2']['focus_max']})"), 400
        move_stepper("stepper2", "forward", steps)
        focus_step += steps
        log_to_console(f"Focus IN: +{steps} steps (total: {focus_step})")
    elif direction == "out":
        if not ignore_focus_limits and focus_step - steps < config["stepper2"]["focus_min"]:
            return jsonify(error=f"Focus limit exceeded (min: {config['stepper2']['focus_min']})"), 400
        move_stepper("stepper2", "backward", steps)
        focus_step -= steps
        log_to_console(f"Focus OUT: -{steps} steps (total: {focus_step})")
    
    focus_state["step"] = focus_step
    save_focus_state(focus_state)
    return jsonify(step=focus_step)

@app.route("/api/sample/take")
def take_sample():
    try:
        steps = config["stepper1"]["steps_take_sample"]
        log_to_console(f"Moving stepper1 ({steps} steps)")
        if led_state:
            led_hw(False)                       # ahorrar: LED apagado mientras gira la bomba
        try:
            move_stepper("stepper1", "forward", steps)
        finally:
            if led_state:
                time.sleep(config["stepper1"].get("led_delay_after_pump", 1.0))
                led_hw(True, suave=True)
        return jsonify(sample={"id": "sample_taken", "time": datetime.now().strftime("%Y-%m-%d %H:%M:%S"), "type": "data"})
    except Exception as e:
        log_to_console(f"Sample error: {str(e)}")
        return jsonify(error="Sample failed"), 500

# ========== Cámara ==========
if CAMERA_AVAILABLE:
    @app.route("/video_feed")
    def video_feed():
        def generate_frames():
            while True:
                if should_clear_annotations():
                    global last_annotated_frame, last_annotation_time
                    last_annotated_frame = None
                    last_annotation_time = 0
                
                if last_annotated_frame is not None:
                    frame = last_annotated_frame
                else:
                    yuv_frame = camera.capture_buffer("lores")
                    yuv_array = np.frombuffer(yuv_frame, dtype=np.uint8)
                    yuv_reshaped = yuv_array.reshape((480 * 3 // 2, 640))
                    frame = cv2.cvtColor(yuv_reshaped, cv2.COLOR_YUV2BGR_I420)
                
                ret, buffer = cv2.imencode('.jpg', frame, [cv2.IMWRITE_JPEG_QUALITY, 80])
                if ret:
                    yield (b'--frame\r\n'
                           b'Content-Type: image/jpeg\r\n\r\n' + buffer.tobytes() + b'\r\n')
                time.sleep(0.05)
        return Response(generate_frames(),
                        mimetype='multipart/x-mixed-replace; boundary=frame')

    @app.route("/api/capture/photo")
    def capture_photo():
        global counter, last_annotated_frame, last_annotation_time
        counter["photo"] += 1
        save_counter(counter)
        img_filename = f"photo_{counter['photo']}.jpg"
        img_path = os.path.join(SAMPLES_DIR, img_filename)
        
        try:
            yuv_frame = camera.capture_buffer("lores")
            yuv_array = np.frombuffer(yuv_frame, dtype=np.uint8)
            yuv_reshaped = yuv_array.reshape((480 * 3 // 2, 640))
            bgr_frame = cv2.cvtColor(yuv_reshaped, cv2.COLOR_YUV2BGR_I420)
            
            cv2.imwrite(img_path, bgr_frame)
            log_to_console(f"Image captured: {img_filename}")
            
            classifications = []
            for (x, y, w, h) in detectar(bgr_frame):   # ml/detector.py
                obj_img = bgr_frame[y:y+h, x:x+w]
                obj_path = os.path.join(SAMPLES_DIR, f"temp_obj_{counter['photo']}_{len(classifications)}.jpg")
                cv2.imwrite(obj_path, obj_img)
                
                result = {"label": "unknown", "confidence": 0.0}
                if CLASSIFIER_AVAILABLE:
                    try:
                        result = classify_image(obj_path)
                        log_to_console(f"Object classification: {result['label']} ({result['confidence']:.1f}%)")
                    except Exception as e:
                        log_to_console(f"Classification error: {e}")
                        result = {"label": "error", "confidence": 0.0}
                
                classifications.append({
                    "x": x,
                    "y": y,
                    "w": w,
                    "h": h,
                    "label": result["label"],
                    "confidence": result["confidence"]
                })
                os.remove(obj_path)
            
            # Generar resumen
            class_count = {}
            for obj in classifications:
                label = obj["label"]
                class_count[label] = class_count.get(label, 0) + 1
            
            if class_count:
                class_list = ", ".join([f"{k}: {v}" for k, v in class_count.items()])
                log_to_console(f"Classification summary: {class_list}")
            else:
                class_list = "No objects classified"
                log_to_console(class_list)
            
            # Dibujar anotaciones (siempre en negro)
            annotated_frame = bgr_frame.copy()
            for obj in classifications:
                x, y, w, h = obj["x"], obj["y"], obj["w"], obj["h"]
                label = obj["label"]
                confidence = obj["confidence"]
                color = (0, 0, 0)  # Negro
                cv2.rectangle(annotated_frame, (x, y), (x+w, y+h), color, 2)
                label_text = f"{label} ({int(confidence)}%)" if confidence > 0 else "unknown"
                cv2.putText(annotated_frame, label_text, (x+5, y-10), cv2.FONT_HERSHEY_SIMPLEX, 0.5, color, 1)
            
            last_annotated_frame = annotated_frame
            last_annotation_time = time.time()
            
            # Guardar la anotada y renombrar la cruda con el mismo nombre + _raw
            if classifications:
                first_class = classifications[0]["label"]
                stem = f"plankton_{first_class}_{counter['photo']}"  # el número evita sobrescribir
                annotated_filename = f"{stem}.jpg"
                annotated_path = os.path.join(SAMPLES_DIR, annotated_filename)
                cv2.imwrite(annotated_path, annotated_frame)
                os.replace(img_path, os.path.join(SAMPLES_DIR, f"{stem}_raw.jpg"))  # la cruda pasa a llamarse como la clasificada
                log_to_console(f"Annotated image saved: {annotated_filename} (+ {stem}_raw.jpg)")
                final_filename = annotated_filename
            else:
                final_filename = img_filename
            
            return jsonify({
                "status": "ok",
                "file": final_filename,
                "class": "multiple",
                "confidence": 0.0,
                "objects": classifications,
                "summary": class_list
            })
            
        except Exception as e:
            log_to_console(f"Photo capture error: {e}")
            return jsonify({"error": "Capture failed"}), 500

    @app.route("/api/capture/video/<action>")
    def capture_video(action):
        global recording, video_encoder, video_output
        if action == "start" and not recording:
            global counter
            counter["video"] += 1
            save_counter(counter)
            filename = f"video_{counter['video']}.h264"
            path = os.path.join(SAMPLES_DIR, filename)
            video_encoder = H264Encoder(5000000)
            video_output = FileOutput(path)
            camera.start_recording(video_encoder, video_output, name="lores")
            recording = True
            app.h264_path = path
            app.mp4_path = path.replace(".h264", ".mp4")
            log_to_console(f"Video started: {filename}")
            return jsonify(status="ok", file=filename)
            
        elif action == "stop" and recording:
            def stop_and_convert():
                try:
                    camera.stop_recording()     # en picamera2 esto también PARA la cámara
                    camera.start()              # sin esto, la vista en vivo y las fotos se quedaban colgadas
                    log_to_console("Recording stopped.")
                except Exception as e:
                    log_to_console(f"Stop error: {e}")
                h264_path = getattr(app, 'h264_path', None)
                mp4_path = getattr(app, 'mp4_path', None)
                if h264_path and mp4_path and os.path.exists(h264_path):
                    log_to_console("Converting to MP4...")
                    try:
                        subprocess.run([
                            "ffmpeg", "-r", "30", "-i", h264_path,
                            "-c:v", "copy", mp4_path
                        ], check=True, stdout=subprocess.DEVNULL, stderr=subprocess.DEVNULL)
                        os.remove(h264_path)
                        log_to_console(f"Video saved: {os.path.basename(mp4_path)}")
                    except Exception as e:
                        log_to_console(f"MP4 failed: {str(e)}")

            convert_thread = threading.Thread(target=stop_and_convert)
            convert_thread.start()
            recording = False
            return jsonify(status="ok")
        return jsonify(status="error"), 400

@app.route("/api/samples")
def list_samples():
    files = []
    for f in os.listdir(SAMPLES_DIR):
        if f.lower().endswith(('.jpg', '.jpeg', '.mp4', '.txt')):
            path = os.path.join(SAMPLES_DIR, f)
            files.append({
                "id": f,
                "time": datetime.fromtimestamp(os.path.getmtime(path)).strftime("%Y-%m-%d %H:%M:%S"),
                "type": "photo" if f.lower().endswith(('.jpg', '.jpeg')) else "video" if f.lower().endswith('.mp4') else "data"
            })
    files.sort(key=lambda x: x["time"], reverse=True)
    return jsonify(files)

@app.route("/samples/<filename>")
def view_sample(filename):
    """Para verla en el navegador (sin descargar)."""
    return send_from_directory(SAMPLES_DIR, filename)

@app.route("/download/<filename>")
def download_sample(filename):
    path = os.path.join(SAMPLES_DIR, filename)
    if os.path.exists(path):
        return send_file(path, as_attachment=True)
    return "File not found", 404

@app.route("/download/all")
def download_all():
    zpath = os.path.join(tempfile.gettempdir(), "planktoscope_samples.zip")
    with zipfile.ZipFile(zpath, "w", zipfile.ZIP_STORED) as z:   # jpg/mp4 ya van comprimidos
        for f in sorted(os.listdir(SAMPLES_DIR)):
            if f.lower().endswith(('.jpg', '.jpeg', '.mp4', '.txt')):
                z.write(os.path.join(SAMPLES_DIR, f), f)
    return send_file(zpath, as_attachment=True, download_name="planktoscope_samples.zip")

@app.route("/api/samples/delete/<filename>", methods=["DELETE"])
def delete_sample(filename):
    path = os.path.join(SAMPLES_DIR, filename)
    if os.path.exists(path):
        os.remove(path)
        log_to_console(f"File deleted: {filename}")
        return jsonify(status="ok")
    return "File not found", 404

@app.route("/api/samples/delete/all", methods=["DELETE"])
def delete_all_samples():
    for f in os.listdir(SAMPLES_DIR):
        if f.lower().endswith(('.jpg', '.jpeg', '.mp4', '.txt')):
            path = os.path.join(SAMPLES_DIR, f)
            os.remove(path)
    global counter
    counter = {"photo": 0, "video": 0}
    save_counter(counter)
    log_to_console("All samples deleted")
    return jsonify(status="ok")

@app.route("/api/console/stream")
def console_stream():
    def generate():
        yield " Modular PlanktoScope console connected.\n\n"
        while True:
            if not log_queue.empty():
                with log_lock:
                    msg = log_queue.get()
                yield f" {msg}\n\n"
            time.sleep(0.3)
    return Response(generate(), mimetype="text/event-stream")

# ========== Inicialización final ==========
config = load_config()
focus_state = load_focus_state()
focus_step = focus_state["step"]
counter = load_counter()

# ========== GPIO ==========
GPIO.setwarnings(False)
GPIO.setmode(GPIO.BCM)
GPIO.setup(config["stepper1"]["dir_pin"], GPIO.OUT)
GPIO.setup(config["stepper1"]["step_pin"], GPIO.OUT)
GPIO.setup(config["stepper1"]["enable_pin"], GPIO.OUT)
GPIO.output(config["stepper1"]["enable_pin"], GPIO.HIGH)

GPIO.setup(config["stepper2"]["dir_pin"], GPIO.OUT)
GPIO.setup(config["stepper2"]["step_pin"], GPIO.OUT)
GPIO.setup(config["stepper2"]["enable_pin"], GPIO.OUT)
GPIO.output(config["stepper2"]["enable_pin"], GPIO.HIGH)

LED_PIN = 11
GPIO.setup(LED_PIN, GPIO.OUT)
GPIO.output(LED_PIN, GPIO.HIGH)
led_state = False

camera = None
video_encoder = None
video_output = None
recording = False

log_queue = Queue()
log_lock = Lock()

def log_to_console(msg):
    with log_lock:
        log_queue.put(f"[{time.strftime('%H:%M:%S')}] {msg}")

if CAMERA_AVAILABLE:
    camera = Picamera2()
    cam_config = camera.create_preview_configuration(lores={"size": (640, 480), "format": "YUV420"})
    camera.configure(cam_config)
    camera.start()
    log_to_console("Camera started")

def _motores_off():
    for k in ("stepper1", "stepper2"):
        GPIO.output(config[k]["enable_pin"], GPIO.HIGH)

atexit.register(_motores_off)  # al salir, motores desactivados y pines sin soltar (nada de GPIO.cleanup)

if __name__ == "__main__":
    log_to_console("Modular PlanktoScope started")
    ignore_focus_limits = False
    app.run(host="0.0.0.0", port=5000, debug=False, threaded=True)
