alexmanuel27/PlanktoScope/(commit log)

2025-11-05 new board
    [0e850c2d-e7ce-4351-bac2-d7c185d7e647.f3d, 17e05918-feff-47e6-b392-b7af91a85d3e.f3d, 1a4a2817-b5f8-420c-9792-b29e91e8dcca.f3d, 1b2bbe5d-ce81-4713-bd27-330c6014a240.f3d, 1d477337-65d0-4aad-b7a3-bad6856ccf32.zip.f3d, 229278cc-a63a-4d60-ae79-3476006706c1.f3d, 39c13b6d-fd2f-492e-8767-e4eedb401456.f3d, 461afe21-81f9-453a-bc91-5f27020606c2.f3d]
2025-11-14 PCB v2
    [Planktoscope-Hat.kicad_pcb, Planktoscope-Hat.kicad_sch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]
2025-12-02 first commint in this repo
    [Planktoscope-Hat.kicad_pcb, Planktoscope-Hat.kicad_sch, pyvenv.cfg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]
2025-12-05 antes de polonia
    [pyvenv.cfg]
2025-12-26 all ready(list ok)
    [Planktoscope-Hat.csv]
2026-10-05 Código tal como está en la Raspberry (05/10/2026)
2026-10-05 Auditoría: estado, diagnóstico, ficha del modelo y fuentes de datos
    [confusion_limpio.csv, confusion_test_original.csv, predicciones_limpio.csv, predicciones_test_original.csv]
2026-10-05 Motores: rampa, cerrojo y desactivar siempre; foto cruda _raw sin sobrescrituras
2026-10-07 Entorno único, energía LED/bomba, foco persistente, hora desde el navegador, zip, sin índice
2026-10-07 Ignore Limits funciona (init ya no se corta); visor de fotos y vídeos en Samples
